mordae/zvonecek/components/led_strip/README.md

# LED Strip Component

This directory contains an implementation for addressable LEDs by different peripherals. Currently only RMT is supported as the led strip backend.

It's compatible with:

* [WS2812](http://www.world-semi.com/Certifications/WS2812B.html)
* SK68XX

This component is used as part of the following ESP-IDF examples:
- [Blink Example](../../get-started/blink).

To learn more about how to use this component, please check API Documentation from header file [led_strip.h](./include/led_strip.h).

Please note that this component is not considered to be a part of ESP-IDF stable API. It may change and it may be removed in the future releases.
