mordae/zvonecek/hw/zvonecek/zvonecek.kicad_pcb

## KiCad design hw/zvonecek/zvonecek.kicad_pcb (2022-12-20)

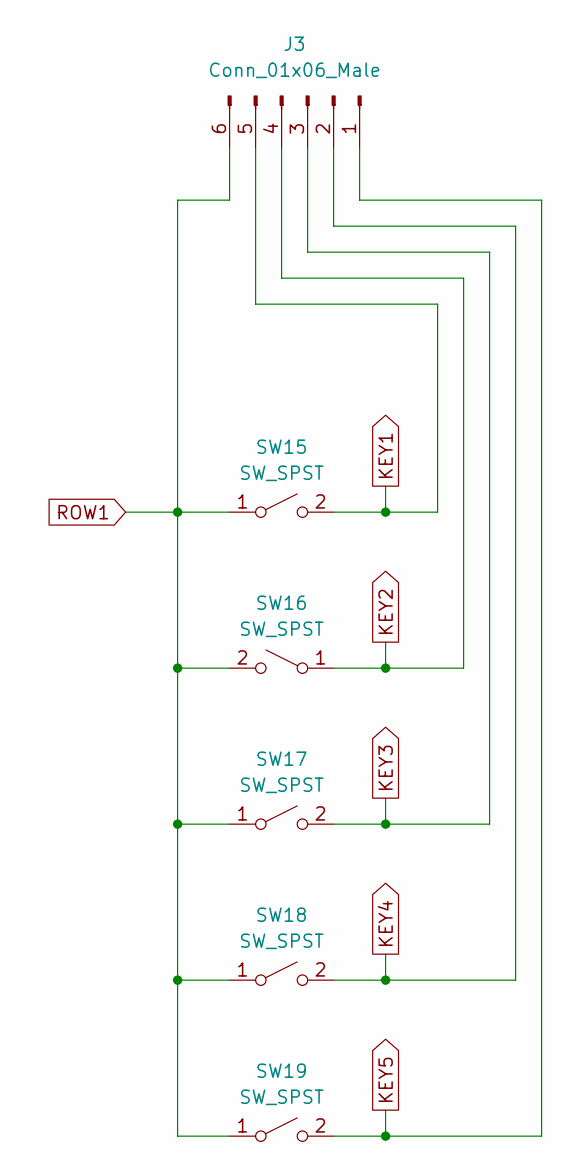
[picture p1: schematic secondary.kicad_sch]

Parts:
J3: Conn_01x06_Male; PinHeader_1x06_P2.54mm_Vertical
SW15, SW16, SW17, SW18, SW19: SW_SPST; BUTTON

Connections:
KEY1: J3.5, SW15.2 (B); also elsewhere on the board
KEY2: J3.4, SW16.1 (A); also elsewhere on the board
KEY3: J3.3, SW17.2 (B); also elsewhere on the board
KEY4: J3.2, SW18.2 (B); also elsewhere on the board
KEY5: J3.1, SW19.2 (B); also elsewhere on the board
ROW1: J3.6, SW15.1 (A), SW16.2 (B), SW17.1 (A), SW18.1 (A), SW19.1 (A); also elsewhere on the board

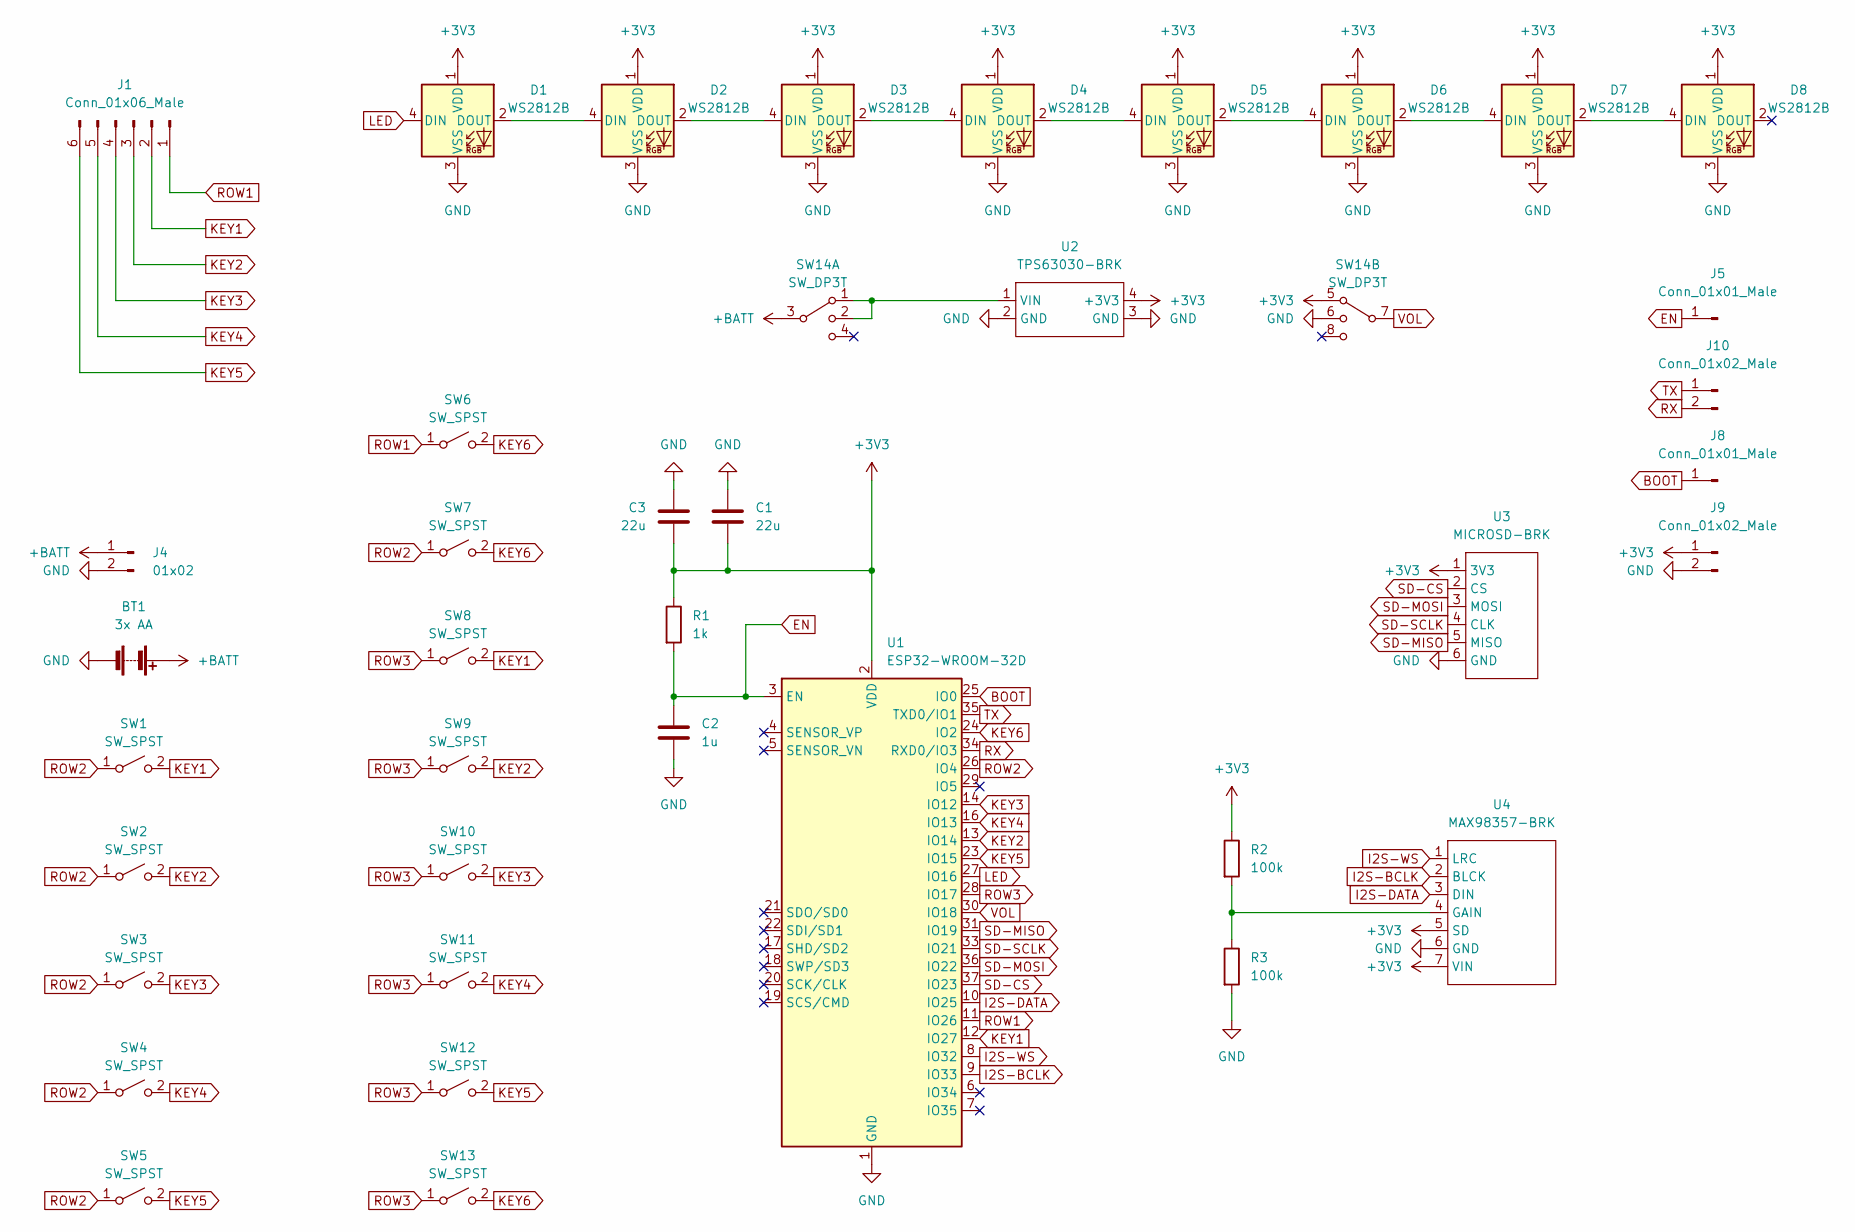
[picture p2: schematic primary.kicad_sch]

Parts:
BT1: 3x AA; PinHeader_1x02_P2.54mm_Horizontal
C1, C3: 22u; C_0603_1608Metric
C2: 1u; C_0805_2012Metric
D1, D2, D3, D4, D5, D6, D7, D8: WS2812B; LED_WS2812B_PLCC4_5.0x5.0mm_P3.2mm
J1: Conn_01x06_Male; PinHeader_1x06_P2.54mm_Vertical
J4: 01x02; PinHeader_1x02_P2.54mm_Vertical
J5, J8: Conn_01x01_Male; PinHeader_1x01_P2.54mm_Vertical
J9, J10: Conn_01x02_Male; PinHeader_1x02_P2.54mm_Vertical
R1: 1k; R_0603_1608Metric
R2, R3: 100k; R_0603_1608Metric
SW1, SW2, SW3, SW4, SW5, SW6, SW7, SW8, SW9, SW10, SW11, SW12, SW13: SW_SPST; BUTTON
SW14: SW_DP3T; SWITCH
U1: ESP32-WROOM-32D; ESP32-WROOM-32
U2: TPS63030-BRK
U3: MICROSD-BRK
U4: MAX98357-BRK

Connections:
+3V3: C1.2, C3.2, D1.1 (VDD), D2.1 (VDD), D3.1 (VDD), D4.1 (VDD), D5.1 (VDD), D6.1 (VDD), D7.1 (VDD), D8.1 (VDD), J9.1, R1.1, R2.1, SW14.5, U1.2 (VDD), U2.4 (+3V3), U3.1 (3V3), U4.5 (SD), U4.7 (VIN)
+BATT: BT1.1 (+), J4.1, SW14.3
BOOT: J8.1, U1.25 (IO0)
EN: C2.1, J5.1, R1.2, U1.3 (EN)
GND: BT1.2 (-), C1.1, C2.2, C3.1, D1.3 (VSS), D2.3 (VSS), D3.3 (VSS), D4.3 (VSS), D5.3 (VSS), D6.3 (VSS), D7.3 (VSS), D8.3 (VSS), J4.2, J9.2, R3.2, SW14.6, U1.1 (GND), U1.15 (GND), U1.38 (GND), U1.39 (GND), U2.2 (GND), U2.3 (GND), U3.6 (GND), U4.6 (GND)
I2S-BCLK: U1.9 (IO33), U4.2 (BLCK)
I2S-DATA: U1.10 (IO25), U4.3 (DIN)
I2S-WS: U1.8 (IO32), U4.1 (LRC)
KEY1: J1.2, SW1.2 (B), SW8.2 (B), U1.12 (IO27); also elsewhere on the board
KEY2: J1.3, SW2.2 (B), SW9.2 (B), U1.13 (IO14); also elsewhere on the board
KEY3: J1.4, SW3.2 (B), SW10.2 (B), U1.14 (IO12); also elsewhere on the board
KEY4: J1.5, SW4.2 (B), SW11.2 (B), U1.16 (IO13); also elsewhere on the board
KEY5: J1.6, SW5.2 (B), SW12.2 (B), U1.23 (IO15); also elsewhere on the board
KEY6: SW6.2 (B), SW7.2 (B), SW13.2 (B), U1.24 (IO2)
LED: D1.4 (DIN), U1.27 (IO16)
unnamed: D1.2 (DOUT), D2.4 (DIN)
unnamed: D2.2 (DOUT), D3.4 (DIN)
unnamed: D3.2 (DOUT), D4.4 (DIN)
unnamed: D4.2 (DOUT), D5.4 (DIN)
unnamed: D5.2 (DOUT), D6.4 (DIN)
unnamed: D6.2 (DOUT), D7.4 (DIN)
unnamed: D7.2 (DOUT), D8.4 (DIN)
unnamed: SW14.1, SW14.2, U2.1 (VIN)
unnamed: R2.2, R3.1, U4.4 (GAIN)
ROW1: J1.1, SW6.1 (A), U1.11 (IO26); also elsewhere on the board
ROW2: SW1.1 (A), SW2.1 (A), SW3.1 (A), SW4.1 (A), SW5.1 (A), SW7.1 (A), U1.26 (IO4)
ROW3: SW8.1 (A), SW9.1 (A), SW10.1 (A), SW11.1 (A), SW12.1 (A), SW13.1 (A), U1.28 (IO17)
RX: J10.2, U1.34 (RXD0/IO3)
SD-CS: U1.37 (IO23), U3.2 (CS)
SD-MISO: U1.31 (IO19), U3.5 (MISO)
SD-MOSI: U1.36 (IO22), U3.3 (MOSI)
SD-SCLK: U1.33 (IO21), U3.4 (CLK)
TX: J10.1, U1.35 (TXD0/IO1)
VOL: SW14.7, U1.30 (IO18)

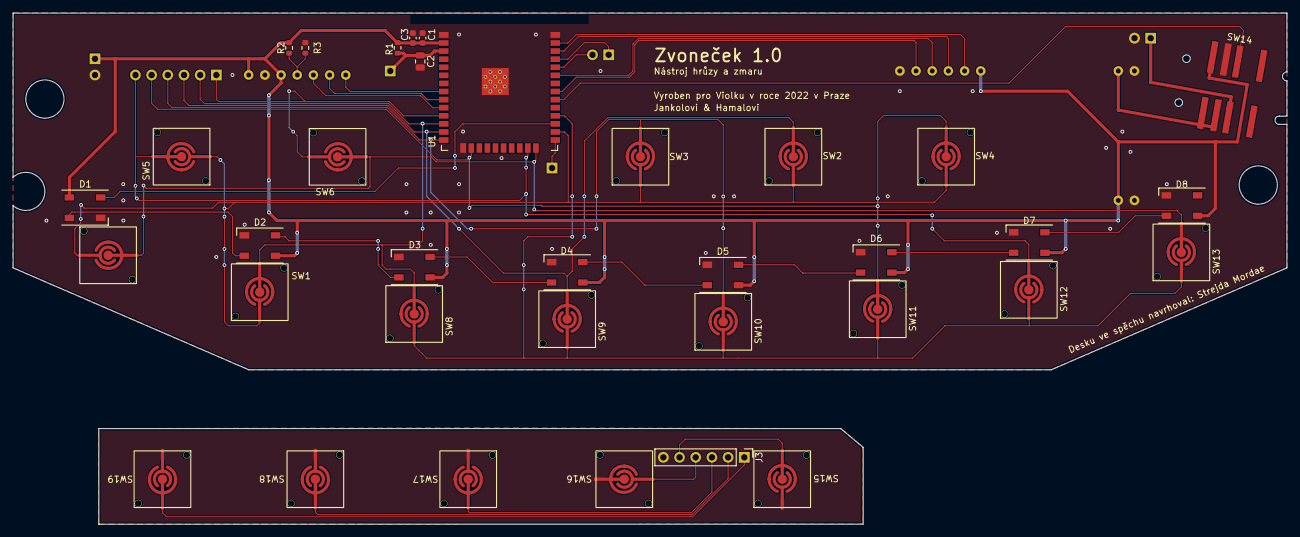
[picture p3: board zvonecek.kicad_pcb from above]

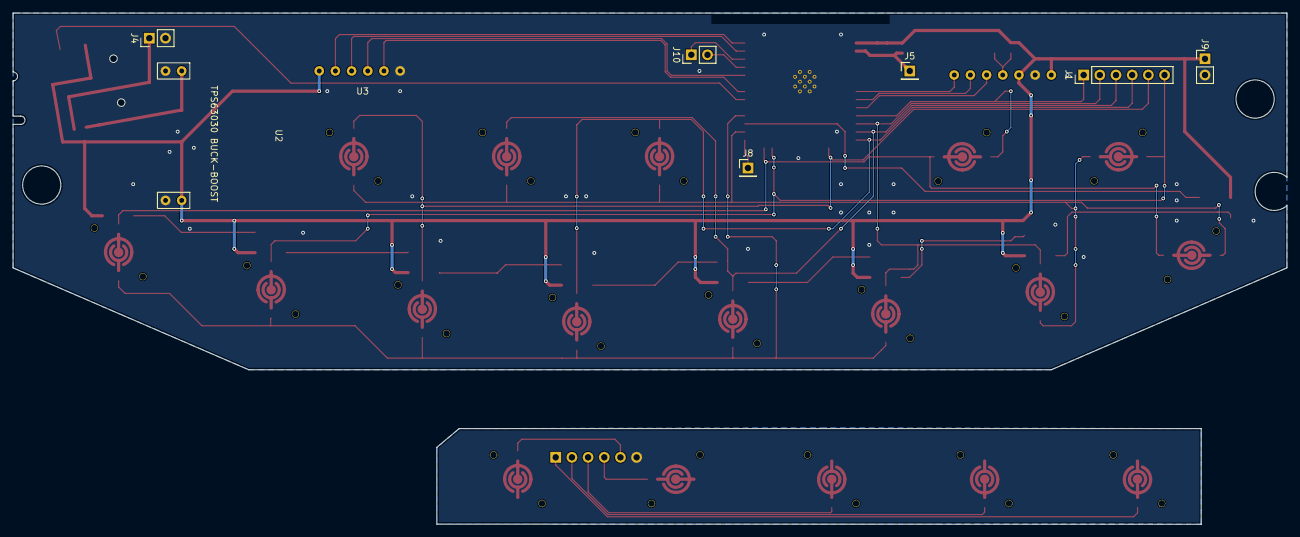
[picture p4: board zvonecek.kicad_pcb from below]

Board: 2 copper layers, 200.0 x 56.0 mm, 44 parts (9 on the bottom side), 34 nets.
