mordae/zvonecek/components/led_strip/src/led_strip_api.c

/*
 * SPDX-FileCopyrightText: 2022 Espressif Systems (Shanghai) CO LTD
 *
 * SPDX-License-Identifier: Apache-2.0
 */
#include "esp_log.h"
#include "esp_check.h"
#include "led_strip.h"
#include "led_strip_interface.h"

static const char *TAG = "led_strip";

esp_err_t led_strip_set_pixel(led_strip_handle_t strip, uint32_t index, uint32_t red, uint32_t green, uint32_t blue)
{
    ESP_RETURN_ON_FALSE(strip, ESP_ERR_INVALID_ARG, TAG, "invalid argument");
    return strip->set_pixel(strip, index, red, green, blue);
}

esp_err_t led_strip_refresh(led_strip_handle_t strip)
{
    ESP_RETURN_ON_FALSE(strip, ESP_ERR_INVALID_ARG, TAG, "invalid argument");
    return strip->refresh(strip);
}

esp_err_t led_strip_clear(led_strip_handle_t strip)
{
    ESP_RETURN_ON_FALSE(strip, ESP_ERR_INVALID_ARG, TAG, "invalid argument");
    return strip->clear(strip);
}

esp_err_t led_strip_del(led_strip_handle_t strip)
{
    ESP_RETURN_ON_FALSE(strip, ESP_ERR_INVALID_ARG, TAG, "invalid argument");
    return strip->del(strip);
}
