mordae/zvonecek/(commit log)

2022-10-23 Add WIP hardware design
    [primary.kicad_sch, secondary.kicad_sch, zvonecek.kicad_pcb, zvonecek.kicad_sch]
2022-12-20 HW design 1.0 as manufactured
    [primary.kicad_sch, secondary.kicad_sch, zvonecek.kicad_pcb, zvonecek.kicad_sch]
2022-12-22 Fix simultaneous key presses and holding
    [main.c, synth.c, synth.h]
2022-12-22 Prevent most troublesome multi-key errors
    [main.c]
2022-12-22 Add two more songs and use leds for highlight
2022-12-23 Make LEDs brighter
2022-12-25 Resolve most of the issues, add final song
    [led.c, main.c, strings.c, strings.h, synth.c, synth.h]
2022-12-25 Suspend RMT when not controlling LEDs
2022-12-25 Enable light sleep to save power
2022-12-28 Add data partition
    [partitions.csv]
2022-12-28 Implement special sounds
    [partitions.csv]
